ElvBry/Gruppe-2-elsys-2025/project git rev/Outputfiles/Krets.pdf

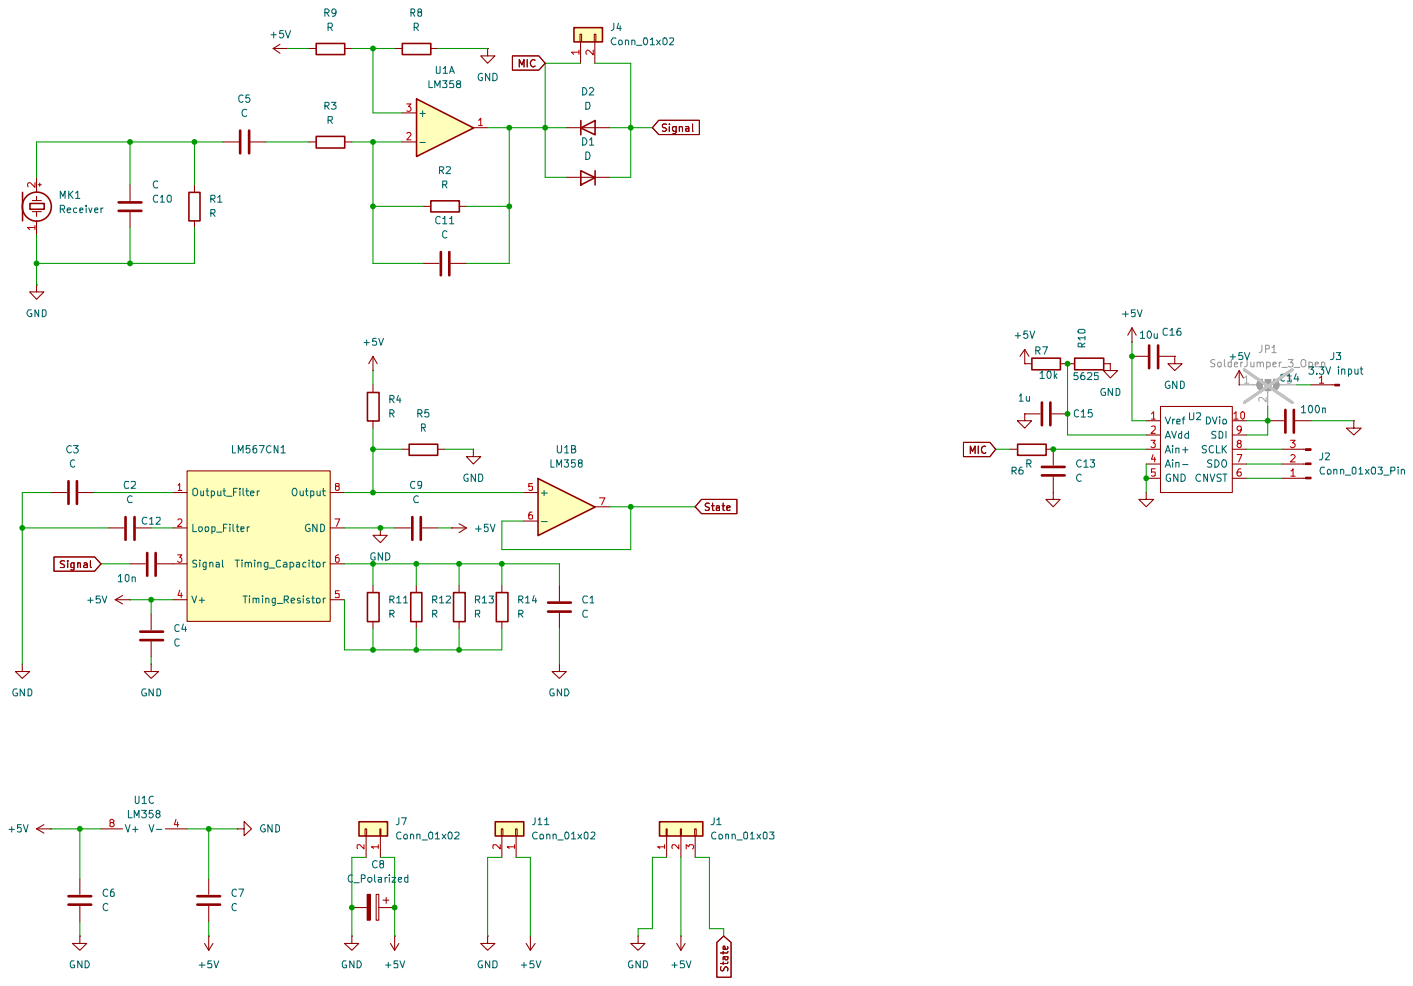
[picture p1: page 1]
