ElvBry/Gruppe-2-elsys-2025/project git rev/project git rev.kicad_pcb

## KiCad design project git rev/project git rev.kicad_pcb (2025-03-10)

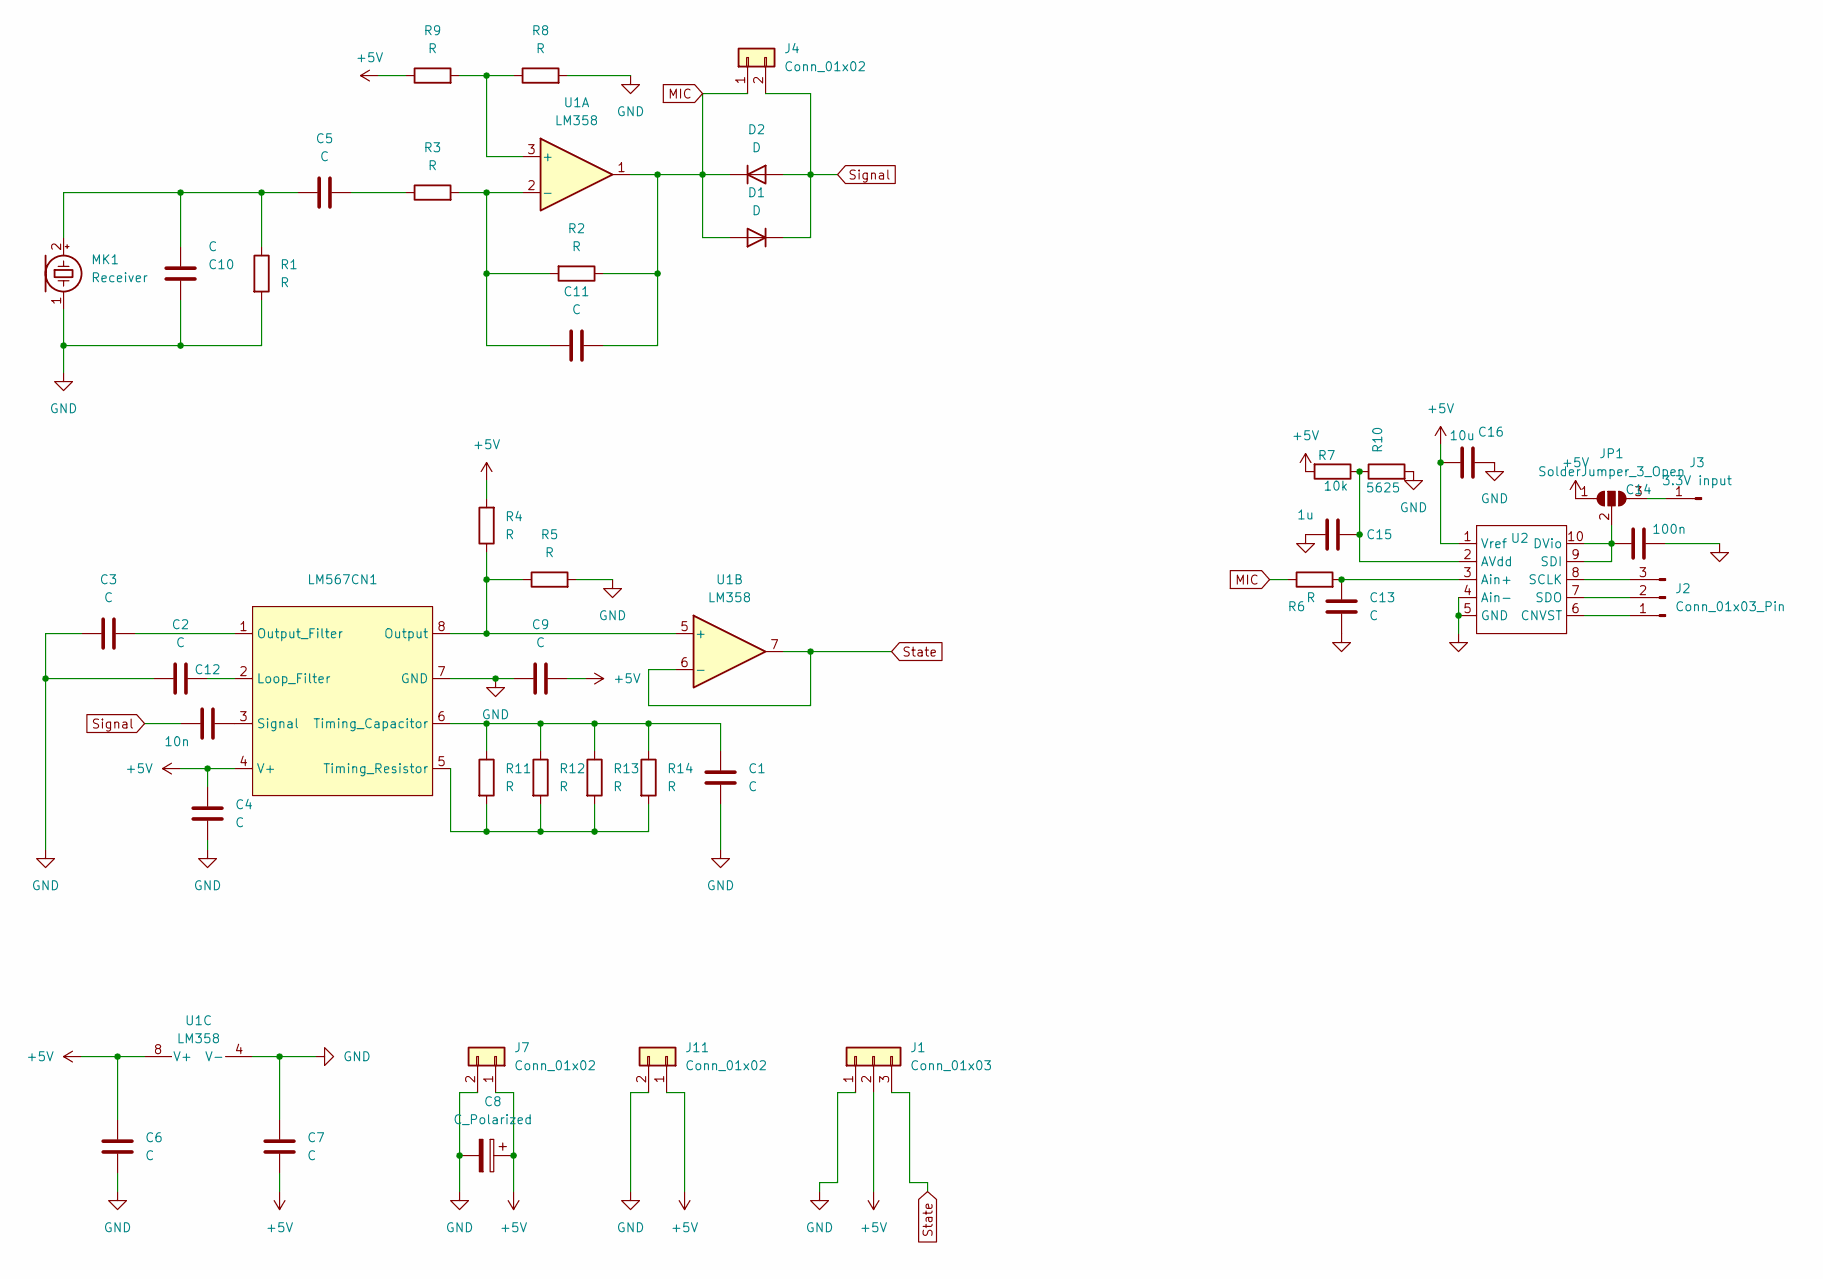
[picture p2: schematic project git rev.kicad_sch]

Parts:
C1, C2, C3, C4, C5, C6, C7, C9, C10, C11, C13: C; C_Rect_L4.6mm_W2.0mm_P2.50mm_MKS02_FKP02
C8: C_Polarized; CP_Radial_D5.0mm_P2.50mm
C12: 10n; C_Rect_L4.6mm_W2.0mm_P2.50mm_MKS02_FKP02
C14: 100n; C_Rect_L4.6mm_W2.0mm_P2.50mm_MKS02_FKP02
C15: 1u; C_Rect_L4.6mm_W2.0mm_P2.50mm_MKS02_FKP02
C16: 10u; C_Rect_L4.6mm_W2.0mm_P2.50mm_MKS02_FKP02
D1, D2: D; D_A-405_P7.62mm_Horizontal
J1: Conn_01x03; PinHeader_1x03_P2.54mm_Vertical
J2: Conn_01x03_Pin; PinHeader_1x03_P2.54mm_Vertical
J3: 3.3V input; PinHeader_1x01_P2.54mm_Vertical
J4, J7, J11: Conn_01x02; PinHeader_1x02_P2.54mm_Vertical
JP1: SolderJumper_3_Open; SolderJumper-3_P2.0mm_Open_TrianglePad1.0x1.5mm
LM567CN1: DIP-8_W10.16mm
MK1: Receiver; UR-1640K-TT-2-R
R1, R2, R3, R4, R5, R6, R8, R9, R11, R12, R13, R14: R; R_Axial_DIN0207_L6.3mm_D2.5mm_P10.16mm_Horizontal
R7: 10k; R_Axial_DIN0207_L6.3mm_D2.5mm_P10.16mm_Horizontal
R10: 5625; R_Axial_DIN0207_L6.3mm_D2.5mm_P10.16mm_Horizontal
U1: LM358; DIP-8_W10.16mm
U2: TDFN-10-1EP_2x3mm_P0.5mm_EP0.9x2mm

Connections:
+5V: C4.2, C6.1, C7.2, C8.1, C9.1, C16.1, J1.2, J7.1, J11.1, JP1.1 (A), LM567CN1.4 (V+), R4.2, R7.2, R9.1, U1.8 (V+), U2.1 (Vref)
GND: C1.2, C2.1, C3.1, C4.1, C6.2, C7.1, C8.2, C9.2, C10.1, C13.2, C14.2, C15.1, C16.2, J1.1, J7.2, J11.2, LM567CN1.7 (GND), MK1.1 (-), R1.2, R5.2, R8.2, R10.2, U1.4 (V-), U2.4 (Ain-), U2.5 (GND)
MIC: C11.2, D1.2 (A), D2.1 (K), J4.1, R2.1, R6.1, U1.1
unnamed: C5.2, R3.1
unnamed: J2.1, U2.6 (CNVST)
unnamed: J2.2, U2.7 (SDO)
unnamed: J2.3, U2.8 (SCLK)
unnamed: J3.1, JP1.3 (B)
unnamed: C14.1, JP1.2 (C), U2.9 (SDI), U2.10 (DVio)
unnamed: C2.2, LM567CN1.2 (Loop_Filter)
unnamed: LM567CN1.8 (Output), R4.1, R5.1, U1.5 (+)
unnamed: C3.2, LM567CN1.1 (Output_Filter)
unnamed: C12.2, LM567CN1.3 (Signal)
unnamed: C1.1, LM567CN1.6 (Timing_Capacitor), R11.1, R12.1, R13.1, R14.1
unnamed: LM567CN1.5 (Timing_Resistor), R11.2, R12.2, R13.2, R14.2
unnamed: C5.1, C10.2, MK1.2 (+), R1.1
unnamed: R8.1, R9.2, U1.3 (+)
unnamed: C11.1, R2.2, R3.2, U1.2 (-)
unnamed: C15.2, R7.1, R10.1, U2.2 (AVdd)
unnamed: C13.1, R6.2, U2.3 (Ain+)
Signal: C12.1, D1.1 (K), D2.2 (A), J4.2
State: J1.3, U1.6 (-), U1.7

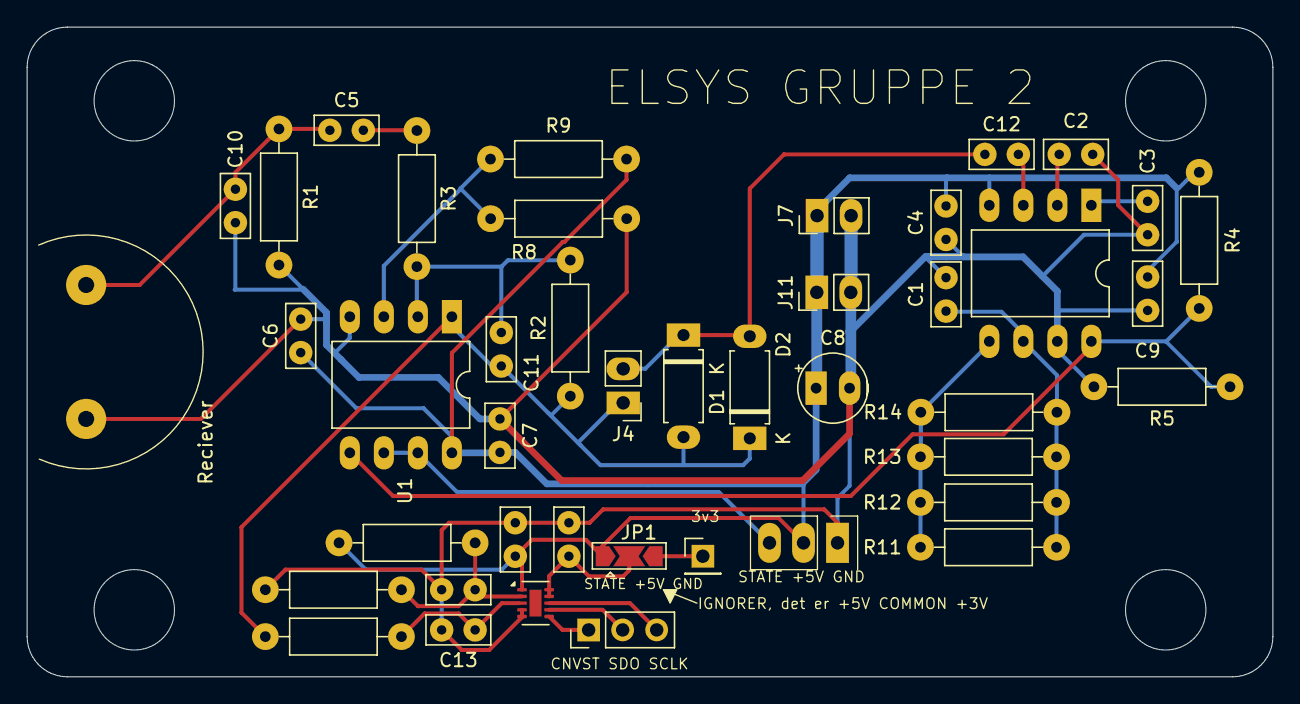
[picture p3: board project git rev.kicad_pcb from above]

Board: 2 copper layers, 93.0 x 48.5 mm, 43 parts (0 on the bottom side), 22 nets.
