ElvBry/Gruppe-2-elsys-2025/(commit log)

2025-02-17 ESP32DSPkode.ino
    stable and working
2025-02-17 Create ESP32_DUMMY_TRANSMITTER.ino
    working dummy transmitter
2025-03-04 Noen estetiske endringer + satt kanten og hull til milimeter grid
    [project git rev.kicad_pcb]
2025-03-06 Endret rutinger slik at referansepunkt ble like for deler av elektronikken (GND/5V) Endret unødvendig tykke ruter til tynne Endret rutene mellom de to strømtilkoblingene til å være 1 mm tykke Formink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
    [project git rev.kicad_pcb]
2025-03-10 La til MCP adcen i kretsen og bestilte 👍
    [project git rev-B_Cu.gbl, project git rev-B_Mask.gbs, project git rev-B_Paste.gbp, project git rev-B_Silkscreen.gbo, project git rev-Edge_Cuts.gm1, project git rev-F_Cu.gtl, project git rev-F_Mask.gts, project git rev-F_Paste.gtp]
2025-03-24 Create ESP32_DUMMY_TRANSMITTER_TOUCH
2025-03-28 Update and rename ESP_kode_folder to ESP32/ESP-DSP-FPGA-NY
2025-03-28 Update and rename ESP-IDF_SPI_SLAVE_TEST to ESP32/SPI_SLAVE_TEST
